AntonioMolteni/BatteryTelemetrySchematic/BOM.xlsx

Instructions
Fill in the cells with the YELLOW highlight. Do not edit red cells. Fill out the Digi-Key part # OR the Mouser Part #, DO NOT fill out both. Choose the cheapest distributor that has the part in stock. If the part is not in stock by the time we order parts, there is a risk that we will not purchase it. |  |  |  |  |  |  |  |  |  |  | Total Price for Project
 |  |  |  |  |  |  |  |  |  |  | $57.89
Qty (for 1 board) | Manufacturer Part # | Digi-key Part#/SKU | Mouser Part#/SKU | Price/unit ($) | Purchase URL | Reference Designator | Description (include component value if applicable) | Datasheet Link | Multiple | Total Qty | Total Price/part ($)
4 | BQ76925PWR | 296-29341-1-ND |  | $2.15 | https://www.digikey.com/en/products/detail/texas-instruments/BQ76925PWR/2728115 |  | IC1-IC4, BMS | https://www.ti.com/lit/ds/symlink/bq76925.pdf |  | 5 | $10.75
28 | CR0805-JW-470ELF | 118-CR0805-JW-470ELFCT-ND |  | $0.10 | https://www.digikey.com/en/products/detail/bourns-inc/CR0805-JW-470ELF/3785326 |  | R1-R28 47R | https://www.bourns.com/docs/product-datasheets/cr.pdf?sfvrsn=574d41f6_14 |  | 50 | $5.00
28 | CL21B105KAFNNNE | 1276-1066-1-ND |  | $0.10 | https://www.digikey.com/en/products/detail/samsung-electro-mechanics/CL21B105KAFNNNE/3886724 |  | C1-C28 1uF | https://mm.digikey.com/Volume0/opasdata/d220001/medias/docus/1105/CL21B105KAFNNNE_Spec.pdf |  | 50 | $5.00
4 | S7B-XH-A | 455-S7B-XH-A-ND |  | $0.49 | https://www.digikey.com/en/products/detail/jst-sales-america-inc/S7B-XH-A/1651038 |  | J1-J4 6S Connectors | https://www.jst-mfg.com/product/pdf/eng/eXH.pdf |  | 5 | $2.45
4 | SMBJ28CA | SMBJ28CALFCT-ND |  | $0.47 | https://www.digikey.com/en/products/detail/littelfuse-inc/SMBJ28CA/286003 |  | D10-D13 TVS Diode | https://www.littelfuse.com/media?itemid=09a6ae9a-73cb-4ac4-acac-e6dab92ab953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 |  | 6 | $2.82
4 | CR0805-JW-101ELF | CR0805-JW-101ELFCT-ND |  | $0.10 | https://www.digikey.com/en/products/detail/bourns-inc/CR0805-JW-101ELF/3741029 |  | R30-33, 100R, LDO | https://www.bourns.com/docs/product-datasheets/cr.pdf?sfvrsn=574d41f6_14 |  | 10 | $1.00
4 | GRM21BR61H106KE43K | 490-GRM21BR61H106KE43KCT-ND |  | $0.34 | https://www.digikey.com/en/products/detail/murata-electronics/GRM21BR61H106KE43K/15191950 |  | C30-C33 10uF/50V | https://search.murata.co.jp/Ceramy/image/img/A01X/G101/ENG/GRM21BR61H106KE43-01A.pdf |  | 4 | $1.36
4 | CR0805-J-000ELF | CR0805-J/-000ELFCT-ND |  | $0.10 | https://www.digikey.com/en/products/detail/bourns-inc/CR0805-J-000ELF/3593157 |  | R53-56 0R, VCout to MCU | https://www.bourns.com/docs/product-datasheets/cr.pdf?sfvrsn=574d41f6_14 |  | 10 | $1.00
4 | CL21B104KBFNNNE | 1276-1180-1-ND |  | $0.10 | https://www.digikey.com/en/products/detail/samsung-electro-mechanics/CL21B104KBFNNNE/3886838 |  | C50-53 0.1uF, VCout to MCU | http://www.samsungsem.com/kr/support/product-search/mlcc/CL21B104KBFNNNE.jsp |  | 10 | $1.00
1 | CR0805-JW-105ELF | CR0805-JW-105ELFCT-ND |  | $0.10 | https://www.digikey.com/en/products/detail/bourns-inc/CR0805-JW-105ELF/3741030 |  | R29, 1MOhms, LDO | https://www.bourns.com/docs/product-datasheets/cr.pdf?sfvrsn=574d41f6_14 |  | 10 | $1.00
1 | CL21A475KPFNNNG | 1276-6464-1-ND |  | $0.10 | https://www.digikey.com/en/products/detail/samsung-electro-mechanics/CL21A475KPFNNNG/3894442 |  | C29, 4.7uF/10V | https://mm.digikey.com/Volume0/opasdata/d220001/medias/docus/915/CL21A475KPFNNNG_Spec.pdf |  | 3 | $0.30
1 | BZT52C30-7-F | BZT52C30-FDICT-ND |  | $0.21 | https://www.digikey.com/en/products/detail/diodes-incorporated/BZT52C30-7-F/755505 |  | D1, Diode, LDO | https://www.diodes.com/assets/Datasheets/ds18004.pdf |  | 2 | $0.42
1 | MBR0540T1G | MBR0540T1GOSCT-ND |  | $0.47 | https://www.digikey.com/en/products/detail/onsemi/MBR0540T1G/918576 |  | D2, Diode, LDO | https://www.onsemi.com/pdf/datasheet/mbr0540t1-d.pdf |  | 2 | $0.94
1 | BZT52C4V7-7-F | BZT52C4V7-FDICT-ND |  | $0.21 | https://www.digikey.com/en/products/detail/diodes-incorporated/BZT52C4V7-7-F/774198 |  | D3, Diode, LDO | https://www.diodes.com/assets/Datasheets/ds18004.pdf |  | 2 | $0.42
1 | ZXTP25040DFHTA | ZXTP25040DFHCT-ND |  | $0.57 | https://www.digikey.com/en/products/detail/diodes-incorporated/ZXTP25040DFHTA/1043601 |  | Q1, BJT, LDO | https://www.diodes.com/assets/Datasheets/ZXTP25040DFH.pdf |  | 2 | $1.14
1 | SC0914(7) | 2648-SC0914(7)CT-ND |  | $0.80 | https://www.digikey.com/en/products/detail/raspberry-pi/SC0914-7/14306009 |  | U1 Controller rp2040 | https://datasheets.raspberrypi.com/rp2040/rp2040-datasheet.pdf |  | 2 | $1.60
1 | USB4085-GF-A | 2073-USB4085-GF-ACT-ND |  | $0.94 | https://www.digikey.com/en/products/detail/gct/USB4085-GF-A/9859662 |  | J5 Type C USB 2.0 receptacle | https://gct.co/files/drawings/usb4085.pdf |  | 1 | $0.94
2 | RC0805FR-0710KL | 311-10.0KCRCT-ND |  | $0.10 | https://www.digikey.com/en/products/detail/yageo/RC0805FR-0710KL/727535 |  | R43, R52 10k | https://www.yageo.com/upload/media/product/products/datasheet/rchip/PYu-RC_Group_51_RoHS_L_12.pdf |  | 2 | $0.20
2 | RC0805JR-075K1L | 311-5.1KARCT-ND |  | $0.10 | https://www.digikey.com/en/products/detail/yageo/RC0805JR-075K1L/728338 |  | R37-R38 5.1k | https://www.yageo.com/upload/media/product/products/datasheet/rchip/PYu-RC_Group_51_RoHS_L_12.pdf |  | 2 | $0.20
2 | CL21A106KOQNNNE | 1276-1096-1-ND |  | $0.10 | https://www.digikey.com/en/products/detail/samsung-electro-mechanics/CL21A106KOQNNNE/3886754 |  | C34-C35 10u | https://mm.digikey.com/Volume0/opasdata/d220001/medias/docus/609/CL21A106KOQNNNE_Spec.pdf |  | 5 | $0.50
1 | NCP1117LPST33T3G | NCP1117LPST33T3GOSCT-ND |  | $0.47 | https://www.digikey.com/en/products/detail/onsemi/NCP1117LPST33T3G/2194024 |  | U2 NCP1117 -3.3V_SOT223 | https://www.onsemi.com/pdf/datasheet/ncp1117lp-d.pdf |  | 0 | $0.00
1 | RC0805JR-0727RL | 311-27ARCT-ND |  | $0.10 | https://www.digikey.com/en/products/detail/yageo/RC0805JR-0727RL/728293 |  | R39-R40 27R | https://www.yageo.com/upload/media/product/products/datasheet/rchip/PYu-RC_Group_51_RoHS_L_12.pdf |  | 10 | $1.00
1 | RC0805FR-071KL | 311-1.00KCRCT-ND |  | $0.10 | https://www.digikey.com/en/products/detail/yageo/RC0805FR-071KL/727444 |  | R41-R42 1k | https://www.yageo.com/upload/media/product/products/datasheet/rchip/PYu-RC_Group_51_RoHS_L_12.pdf |  | 10 | $1.00
10 | CC0805KRX7R9BB104 | 311-1140-1-ND |  | $0.10 | https://www.digikey.com/en/products/detail/yageo/CC0805KRX7R9BB104/302874 |  | C36-C45 100n (0.1u) | https://www.yageo.com/upload/media/product/app/datasheet/mlcc/upy-gphc_x7r_6_3v-to-250v.pdf |  | 20 | $2.00
2 | CL21B105KAFNNNE | 1276-1066-1-ND |  | $0.10 | https://www.digikey.com/en/products/detail/samsung-electro-mechanics/CL21B105KAFNNNE/3886724 |  | C46-C47 1u | https://mm.digikey.com/Volume0/opasdata/d220001/medias/docus/1105/CL21B105KAFNNNE_Spec.pdf |  | 0 | $0.00
2 | MJTP1243 | 679-2452-ND |  | $0.36 | https://www.digikey.com/en/products/detail/apem-inc/MJTP1243/1798039?s=N4IgTCBcDaILYCsAuAHAjGALAZhAXQF8g |  | SW1-SW2 | https://mm.digikey.com/Volume0/opasdata/d220001/medias/docus/5561/MJTP%20thruhole.pdf |  | 4 | $1.44
1 | PPPC041LFBN-RC | S7037-ND |  | $0.47 | https://www.digikey.com/en/products/detail/sullins-connector-solutions/PPPC041LFBN-RC/810176 |  | J6 1 by 4 female header | https://mm.digikey.com/Volume0/opasdata/d220001/medias/docus/937/Female_Headers.100_DS.pdf |  | 2 | $0.94
1 | TCA9548APWR | 296-34905-1-ND |  | $1.60 | https://www.digikey.com/en/products/detail/texas-instruments/TCA9548APWR/3615458 |  | U4 I2C Multiplexer | https://www.ti.com/general/docs/suppproductinfo.tsp?distId=10 |  | 2
11 | RC0805FR-073K3L | 311-3.30KCRCT-ND |  | $0.10 | https://www.digikey.com/en/products/detail/yageo/RC0805FR-073K3L/727813 |  | R34-R36,R44-R51 3.3kOhm | https://www.yageo.com/upload/media/product/products/datasheet/rchip/PYu-RC_Group_51_RoHS_L_12.pdf |  | 20 | $2.00
4 | CUS05S30,H3F | CUS05S30H3FCT-ND |  | $0.31 | https://www.digikey.com/en/products/detail/toshiba-semiconductor-and-storage/CUS05S30-H3F/5114296 |  | D4-D7 | https://toshiba.semicon-storage.com/info/CUS05S30_datasheet_en_20140407.pdf?did=13983&prodName=CUS05S30 |  | 6 | $1.86
2 | PPPC031LFBN-RC | S7036-ND |  | $0.38 | https://www.digikey.com/en/products/detail/sullins-connector-solutions/PPPC031LFBN-RC/810175 |  | J7-J8 1 by 3 female header | https://mm.digikey.com/Volume0/opasdata/d220001/medias/docus/937/Female_Headers.100_DS.pdf |  | 4 | $1.52
1 | EG1271 | EG1918-ND |  | $0.85 | https://www.digikey.com/en/products/detail/e-switch/EG1271/251335 |  | SW3 SPDT | https://sten-eswitch-13110800-production.s3.amazonaws.com/system/asset/product_line/data_sheet/119/EG.pdf |  | 2 | $1.70
1 | W25Q128JVSIQ TR | W25Q128JVSIQCT-ND |  | $1.78 | https://www.digikey.com/en/products/detail/winbond-electronics/W25Q128JVSIQ-TR/5803944 |  | U4 W25Q128JVS | https://www.winbond.com/resource-files/w25q128jv%20revf%2003272018%20plus.pdf |  | 2 | $3.56
1 | ABM10AIG-12.000MHZ-4Z-T3 | 535-13360-1-ND |  | $0.61 | https://www.digikey.com/en/products/detail/abracon-llc/ABM10AIG-12-000MHZ-4Z-T3/5817560 |  | Y1 Crystal (AMB8-282-T3 Not available) | https://abracon.com/AIGcrystals/ABM10AIG.pdf |  | 3 | $1.83
2 | CC0805JRNPO9BN150 | 311-1101-1-ND |  | $0.10 | https://www.digikey.com/en/products/detail/yageo/CC0805JRNPO9BN150/302835 |  | C48-C49 15p | https://www.yageo.com/upload/media/product/productsearch/datasheet/mlcc/UPY-GP_NP0_16V-to-50V_18.pdf |  | 10 | $1.00
