AntonioMolteni/BatteryTelemetrySchematic/Project Library/BQ76925PWR/BQ76925PWR.step

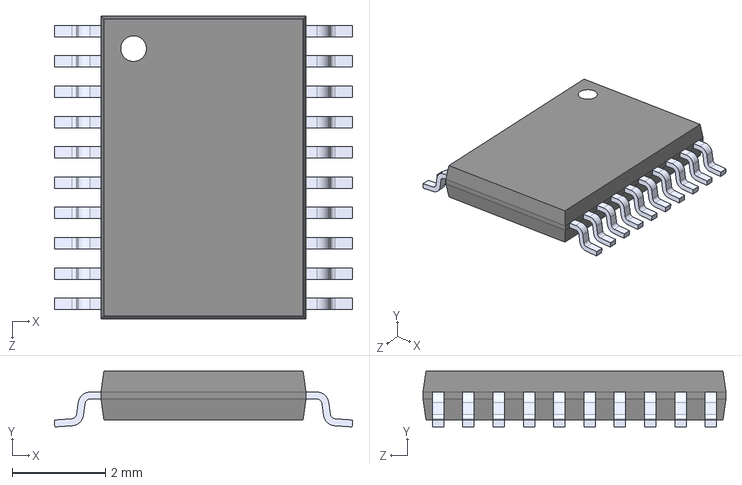
[picture p1: CAD file, 2024-03-25]
Project Library/BQ76925PWR/BQ76925PWR.step
6.40 x 1.20 x 6.50 mm
