AntonioMolteni/BatteryTelemetrySchematic/Print.pdf

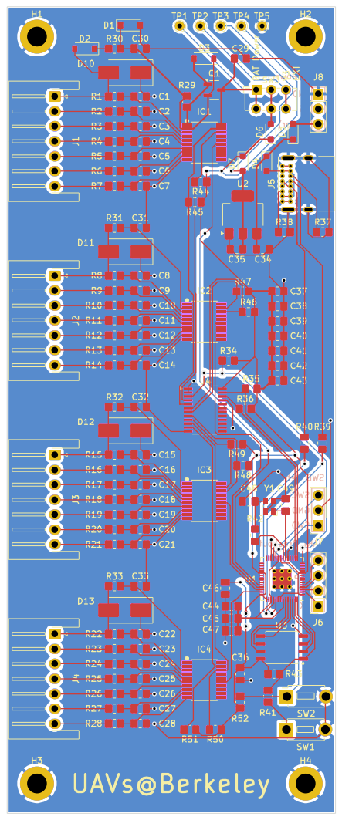
[picture p2: page 1]
