AntonioMolteni/BatteryTelemetrySchematic/BatteryTelemetry.kicad_pcb

## KiCad design BatteryTelemetry.kicad_pcb (2024-05-05)

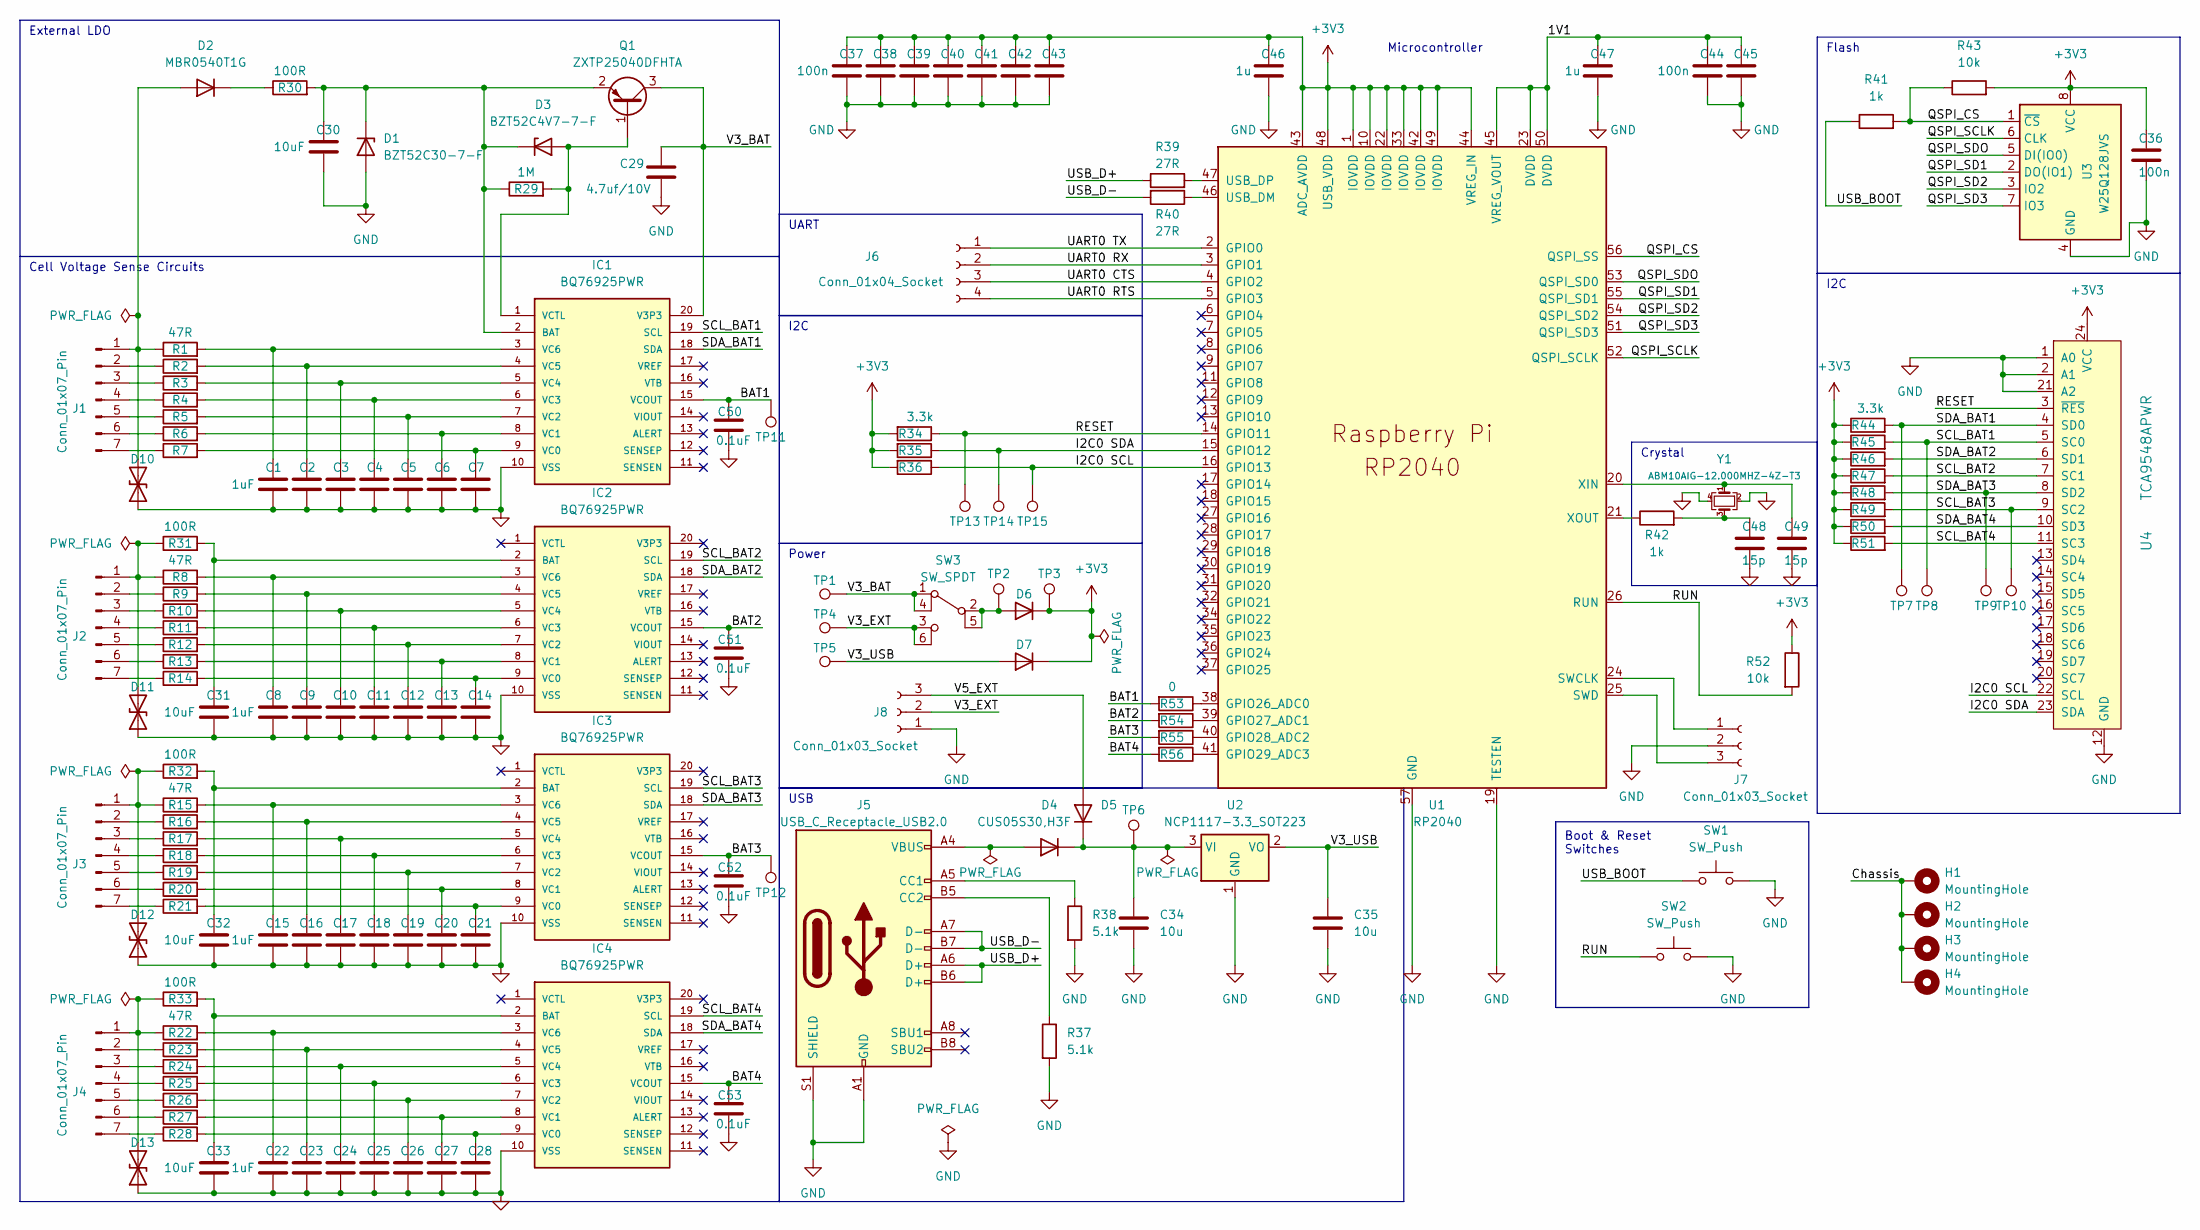
[picture p3: schematic BatteryTelemetry.kicad_sch, Battery Telemetry Schematic]

Parts:
C1, C2, C3, C4, C5, C6, C7, C8, C9, C10, C11, C12, C13, C14, C15, C16, C17, C18, C19, C20, C21, C22, C23, C24, C25, C26, C27, C28: 1uF; C_0805_2012Metric_Pad1.18x1.45mm_HandSolder
C29: 4.7uf/10V; C_0805_2012Metric_Pad1.18x1.45mm_HandSolder
C30, C31, C32, C33: 10uF; C_0805_2012Metric_Pad1.18x1.45mm_HandSolder
C34, C35: 10u; C_0805_2012Metric_Pad1.18x1.45mm_HandSolder
C36, C37, C38, C39, C40, C41, C42, C43, C44, C45: 100n; C_0805_2012Metric_Pad1.18x1.45mm_HandSolder
C46, C47: 1u; C_0805_2012Metric_Pad1.18x1.45mm_HandSolder
C48, C49: 15p; C_0805_2012Metric_Pad1.18x1.45mm_HandSolder
C50, C51, C52, C53: 0.1uF; C_0805_2012Metric_Pad1.18x1.45mm_HandSolder
D1: BZT52C30-7-F; D_SOD-123
D2: MBR0540T1G; D_SOD-123
D3: BZT52C4V7-7-F; D_SOD-123
D4, D5, D6, D7: CUS05S30,H3F; D_SOD-323_HandSoldering
D10, D11, D12, D13: SMBJ28CA; D_SMB_Handsoldering
H1, H2, H3, H4: MountingHole; MountingHole_3.2mm_M3_DIN965_Pad
IC1, IC2, IC3, IC4: BQ76925PWR; SOP65P640X120-20N; MOUSER_PART_NUMBER 595-BQ76925PWR; DigiKey_Part_Number 296-29341-2-ND
J1, J2, J3, J4: Conn_01x07_Pin; JST_XH_S7B-XH-A-1_1x07_P2.50mm_Horizontal
J5: USB_C_Receptacle_USB2.0; USB_C_Receptacle_GCT_USB4085
J6: Conn_01x04_Socket; PinSocket_1x04_P2.54mm_Vertical
J7, J8: Conn_01x03_Socket; PinSocket_1x03_P2.54mm_Vertical
Q1: ZXTP25040DFHTA; SOT-23-3
R1, R2, R3, R4, R5, R6, R7, R8, R9, R10, R11, R12, R13, R14, R15, R16, R17, R18, R19, R20, R21, R22, R23, R24, R25, R26, R27, R28: 47R; R_0805_2012Metric_Pad1.20x1.40mm_HandSolder
R29: 1M; R_0805_2012Metric_Pad1.20x1.40mm_HandSolder
R30, R31, R32, R33: 100R; R_0805_2012Metric_Pad1.20x1.40mm_HandSolder
R34, R35, R36, R44, R45, R46, R47, R48, R49, R50, R51: 3.3k; R_0805_2012Metric_Pad1.20x1.40mm_HandSolder
R37, R38: 5.1k; R_0805_2012Metric_Pad1.20x1.40mm_HandSolder
R39, R40: 27R; R_0805_2012Metric_Pad1.20x1.40mm_HandSolder
R41, R42: 1k; R_0805_2012Metric_Pad1.20x1.40mm_HandSolder
R43, R52: 10k; R_0805_2012Metric_Pad1.20x1.40mm_HandSolder
R53, R54, R55, R56: 0; R_0805_2012Metric_Pad1.20x1.40mm_HandSolder
SW1, SW2: SW_Push; SW_PUSH_1P1T_6x3.5mm_H4.3_APEM_MJTP1243
SW3: SW_SPDT; SW_E-Switch_EG1271_SPDT
TP1, TP2, TP3, TP4, TP5, TP6, TP7, TP8, TP9, TP10, TP11, TP12, TP13, TP14, TP15: TestPoint; TestPoint_THTPad_D1.5mm_Drill0.7mm
U1: RP2040; RP2040-QFN-56
U2: NCP1117-3.3_SOT223; SOT-223-3_TabPin2
U3: W25Q128JVS; SOIC-8_5.23x5.23mm_P1.27mm
U4: TCA9548APWR; TSSOP-24_4.4x7.8mm_P0.65mm; MPN TCA9548APWR; Digi-Key_PN 296-34905-1-ND
Y1: ABM10AIG-12.000MHZ-4Z-T3; Crystal_SMD_Abracon_ABM10-4Pin_2.5x2.0mm

Connections:
+3V3: C36.1, C37.1, C38.1, C39.1, C40.1, C41.1, C42.1, C43.1, C46.1, D6.1 (K), D7.1 (K), R34.2, R35.2, R36.2, R43.2, R44.1, R45.1, R46.1, R47.1, R48.1, R49.1, R50.1, R51.1, R52.1, TP3.1, U1.1 (IOVDD), U1.10 (IOVDD), U1.22 (IOVDD), U1.33 (IOVDD), U1.42 (IOVDD), U1.43 (ADC_AVDD), U1.44 (VREG_IN), U1.48 (USB_VDD), U1.49 (IOVDD), U3.8 (VCC), U4.24 (VCC)
/1V1: C44.1, C45.1, C47.1, U1.23 (DVDD), U1.45 (VREG_VOUT), U1.50 (DVDD)
/BAT1: C50.1, IC1.15 (VCOUT), R53.2, TP11.1
/BAT2: C51.1, IC2.15 (VCOUT), R54.2
/BAT3: C52.1, IC3.15 (VCOUT), R55.2, TP12.1
/BAT4: C53.1, IC4.15 (VCOUT), R56.2
/Chassis: H1.1, H2.1, H3.1, H4.1
/I2C0 SCL: R36.1, TP15.1, U1.16 (GPIO13), U4.22 (SCL)
/I2C0 SDA: R35.1, TP14.1, U1.15 (GPIO12), U4.23 (SDA)
/QSPI_CS: R41.2, R43.1, U1.56 (QSPI_SS), U3.1 (~CS)
/QSPI_SCLK: U1.52 (QSPI_SCLK), U3.6 (CLK)
/QSPI_SD1: U1.55 (QSPI_SD1), U3.2 (DO(IO1))
/QSPI_SD2: U1.54 (QSPI_SD2), U3.3 (IO2)
/QSPI_SD3: U1.51 (QSPI_SD3), U3.7 (IO3)
/QSPI_SDO: U1.53 (QSPI_SD0), U3.5 (DI(IO0))
/RESET: R34.1, TP13.1, U1.14 (GPIO11), U4.3 (~RES)
/RUN: R52.2, SW2.1, U1.26 (RUN)
/SCL_BAT1: IC1.19 (SCL), R45.2, TP8.1, U4.5 (SC0)
/SCL_BAT2: IC2.19 (SCL), R47.2, U4.7 (SC1)
/SCL_BAT3: IC3.19 (SCL), R49.2, TP10.1, U4.9 (SC2)
/SCL_BAT4: IC4.19 (SCL), R51.2, U4.11 (SC3)
/SDA_BAT1: IC1.18 (SDA), R44.2, TP7.1, U4.4 (SD0)
/SDA_BAT2: IC2.18 (SDA), R46.2, U4.6 (SD1)
/SDA_BAT3: IC3.18 (SDA), R48.2, TP9.1, U4.8 (SD2)
/SDA_BAT4: IC4.18 (SDA), R50.2, U4.10 (SD3)
/UART0 CTS: J6.3, U1.4 (GPIO2)
/UART0 RTS: J6.4, U1.5 (GPIO3)
/UART0 RX: J6.2, U1.3 (GPIO1)
/UART0 TX: J6.1, U1.2 (GPIO0)
/USB_BOOT: R41.1, SW1.1
/USB_D+: J5.A6 (D+), J5.B6 (D+), R39.1
/USB_D-: J5.A7 (D-), J5.B7 (D-), R40.2
/V3_BAT: C29.1, IC1.20 (V3P3), Q1.3 (C), SW3.1 (A), SW3.4, TP1.1
/V3_EXT: J8.2, SW3.3 (C), SW3.6, TP4.1
/V3_USB: C35.1, D7.2 (A), TP5.1, U2.2 (VO)
/V5_EXT: D5.2 (A), J8.3
GND: C1.2, C2.2, C3.2, C4.2, C5.2, C6.2, C7.2, C8.2, C9.2, C10.2, C11.2, C12.2, C13.2, C14.2, C15.2, C16.2, C17.2, C18.2, C19.2, C20.2, C21.2, C22.2, C23.2, C24.2, C25.2, C26.2, C27.2, C28.2, C29.2, C30.2, C31.2, C32.2, C33.2, C34.2, C35.2, C36.2, C37.2, C38.2, C39.2, C40.2, C41.2, C42.2, C43.2, C44.2, C45.2, C46.2, C47.2, C48.2, C49.2, C50.2, C51.2, C52.2, C53.2, D1.2 (A), D10.1 (A1), D11.1 (A1), D12.1 (A1), D13.1 (A1), IC1.10 (VSS), IC2.10 (VSS), IC3.10 (VSS), IC4.10 (VSS), J5.A1 (GND), J5.A12 (GND), J5.B1 (GND), J5.B12 (GND), J5.S1 (SHIELD), J7.2, J8.1, R37.2, R38.2, SW1.2, SW2.2, U1.19 (TESTEN), U1.57 (GND), U2.1 (GND), U3.4 (GND), U4.1 (A0), U4.2 (A1), U4.12 (GND), U4.21 (A2), Y1.2, Y1.4
unnamed: C48.1, R42.2, Y1.3
unnamed: C30.1, D1.1 (K), D3.1 (K), IC1.2 (BAT), Q1.2 (E), R29.1, R30.2
unnamed: D2.1 (K), R30.1
unnamed: D3.2 (A), IC1.1 (VCTL), Q1.1 (B), R29.2
unnamed: D4.2 (A), J5.A4 (VBUS), J5.A9 (VBUS), J5.B4 (VBUS), J5.B9 (VBUS)
unnamed: C34.1, D4.1 (K), D5.1 (K), TP6.1, U2.3 (VI)
unnamed: D6.2 (A), SW3.2 (B), SW3.5, TP2.1
unnamed: D2.2 (A), D10.2 (A2), J1.1, R1.1
unnamed: D11.2 (A2), J2.1, R8.1, R31.1
unnamed: D12.2 (A2), J3.1, R15.1, R32.1
unnamed: D13.2 (A2), J4.1, R22.1, R33.1
unnamed: C7.1, IC1.9 (VC0), R7.2
unnamed: C6.1, IC1.8 (VC1), R6.2
unnamed: C5.1, IC1.7 (VC2), R5.2
unnamed: C4.1, IC1.6 (VC3), R4.2
unnamed: C3.1, IC1.5 (VC4), R3.2
unnamed: C2.1, IC1.4 (VC5), R2.2
unnamed: C1.1, IC1.3 (VC6), R1.2
unnamed: C31.1, IC2.2 (BAT), R31.2
unnamed: C14.1, IC2.9 (VC0), R14.2
unnamed: C13.1, IC2.8 (VC1), R13.2
unnamed: C12.1, IC2.7 (VC2), R12.2
unnamed: C11.1, IC2.6 (VC3), R11.2
unnamed: C10.1, IC2.5 (VC4), R10.2
unnamed: C9.1, IC2.4 (VC5), R9.2
unnamed: C8.1, IC2.3 (VC6), R8.2
unnamed: C32.1, IC3.2 (BAT), R32.2
unnamed: C21.1, IC3.9 (VC0), R21.2
unnamed: C20.1, IC3.8 (VC1), R20.2
unnamed: C19.1, IC3.7 (VC2), R19.2
unnamed: C18.1, IC3.6 (VC3), R18.2
unnamed: C17.1, IC3.5 (VC4), R17.2
unnamed: C16.1, IC3.4 (VC5), R16.2
unnamed: C15.1, IC3.3 (VC6), R15.2
unnamed: C33.1, IC4.2 (BAT), R33.2
unnamed: C28.1, IC4.9 (VC0), R28.2
unnamed: C27.1, IC4.8 (VC1), R27.2
unnamed: C26.1, IC4.7 (VC2), R26.2
unnamed: C25.1, IC4.6 (VC3), R25.2
unnamed: C24.1, IC4.5 (VC4), R24.2
unnamed: C23.1, IC4.4 (VC5), R23.2
unnamed: C22.1, IC4.3 (VC6), R22.2
unnamed: J1.2, R2.1
unnamed: J1.3, R3.1
unnamed: J1.4, R4.1
unnamed: J1.5, R5.1
unnamed: J1.6, R6.1
unnamed: J1.7, R7.1
unnamed: J2.2, R9.1
unnamed: J2.3, R10.1
unnamed: J2.4, R11.1
unnamed: J2.5, R12.1
unnamed: J2.6, R13.1
unnamed: J2.7, R14.1
unnamed: J3.2, R16.1
unnamed: J3.3, R17.1
unnamed: J3.4, R18.1
unnamed: J3.5, R19.1
unnamed: J3.6, R20.1
unnamed: J3.7, R21.1
unnamed: J4.2, R23.1
unnamed: J4.3, R24.1
unnamed: J4.4, R25.1
unnamed: J4.5, R26.1
unnamed: J4.6, R27.1
unnamed: J4.7, R28.1
unnamed: J5.A5 (CC1), R38.1
unnamed: J5.B5 (CC2), R37.1
unnamed: J7.1, U1.24 (SWCLK)
unnamed: J7.3, U1.25 (SWD)
unnamed: R53.1, U1.38 (GPIO26_ADC0)
unnamed: R54.1, U1.39 (GPIO27_ADC1)
unnamed: R55.1, U1.40 (GPIO28_ADC2)
unnamed: R56.1, U1.41 (GPIO29_ADC3)
unnamed: R40.1, U1.46 (USB_DM)
unnamed: R39.2, U1.47 (USB_DP)
unnamed: C49.1, U1.20 (XIN), Y1.1
unnamed: R42.1, U1.21 (XOUT)

Notes on the sheet:
UART
Power
Boot & Reset Switches
Cell Voltage Sense Circuits
I2C
Microcontroller
Flash
External LDO
Crystal
USB
I2C

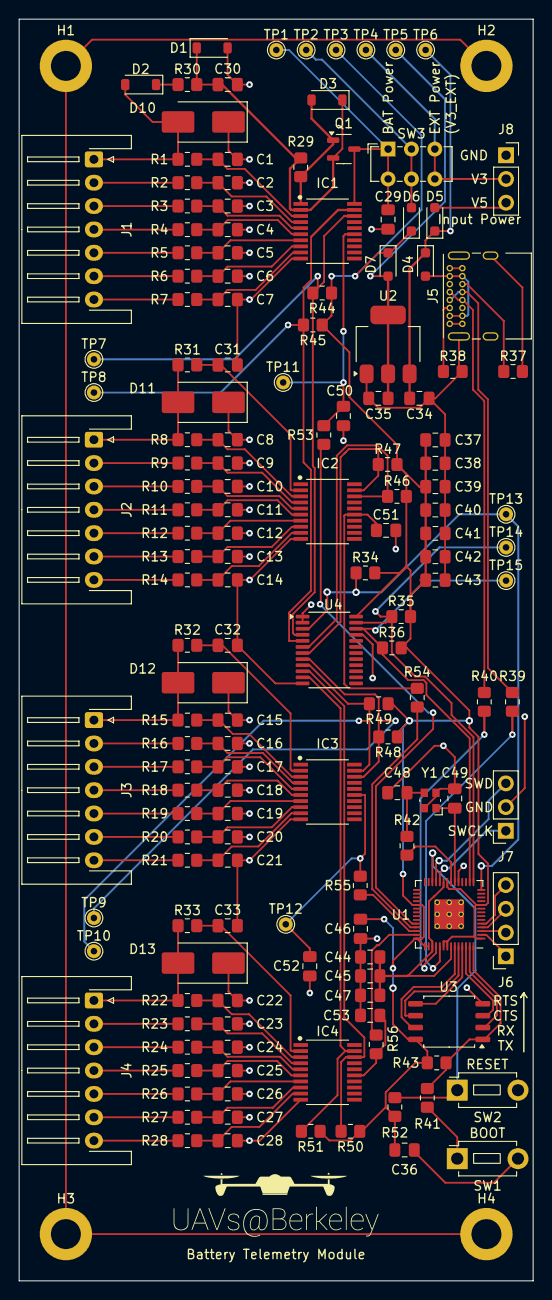
[picture p4: board BatteryTelemetry.kicad_pcb from above]

Board: 2 copper layers, 55.0 x 135.0 mm, 160 parts (0 on the bottom side), 115 nets.
