AntonioMolteni/BatteryTelemetrySchematic/(commit log)

2024-03-25 schematic complete
    [BQ76925PWR.step, BatteryTelemetry.kicad_pcb]
2024-04-02 footprint v1 (unfinished)
    [BatteryTelemetry.kicad_pcb]
2024-04-02 footprint v2 (nothing new)
2024-04-03 button fixed
    [BatteryTelemetry.kicad_pcb, BatteryTelemetry.kicad_sch]
2024-04-06 Layout Complete
    [BatteryTelemetry.kicad_pcb, BatteryTelemetry.kicad_sch]
2024-04-09 finished layout
    [BatteryTelemetry.kicad_pcb]
2024-04-11 Updated Layout
    [BatteryTelemetry.kicad_pcb, BatteryTelemetry.kicad_sch]
2024-04-21 RC circuit for VCout
    [BatteryTelemetry.kicad_pcb, BatteryTelemetry.kicad_sch]
2024-04-22 RC for Vcout Layout Updated
    [BatteryTelemetry.kicad_pcb]
2024-04-24 Layout updated
    [BatteryTelemetry-B_Cu.gbr, BatteryTelemetry-B_Mask.gbr, BatteryTelemetry-B_Paste.gbr, BatteryTelemetry-B_Silkscreen.gbr, BatteryTelemetry-Edge_Cuts.gbr, BatteryTelemetry-F_Cu.gbr, BatteryTelemetry-F_Mask.gbr, BatteryTelemetry-F_Paste.gbr]
2024-04-24 gerbers updated
2024-05-05 Logo added
    [BOM.xlsx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]
